moonpunchorg/octeleshield/README.md

# Overclocking telemetry shield for Arduino Yún

Shield for overclocking telemetry, including:

* multi-channel thermocouple measurement
* multi-channel voltrage measurement

## License

Released under [CERN Open Hardware License 1.2](http://www.ohwr.org/projects/cernohl/wiki).
