moonpunchorg/octeleshield/octeleshield.pdf

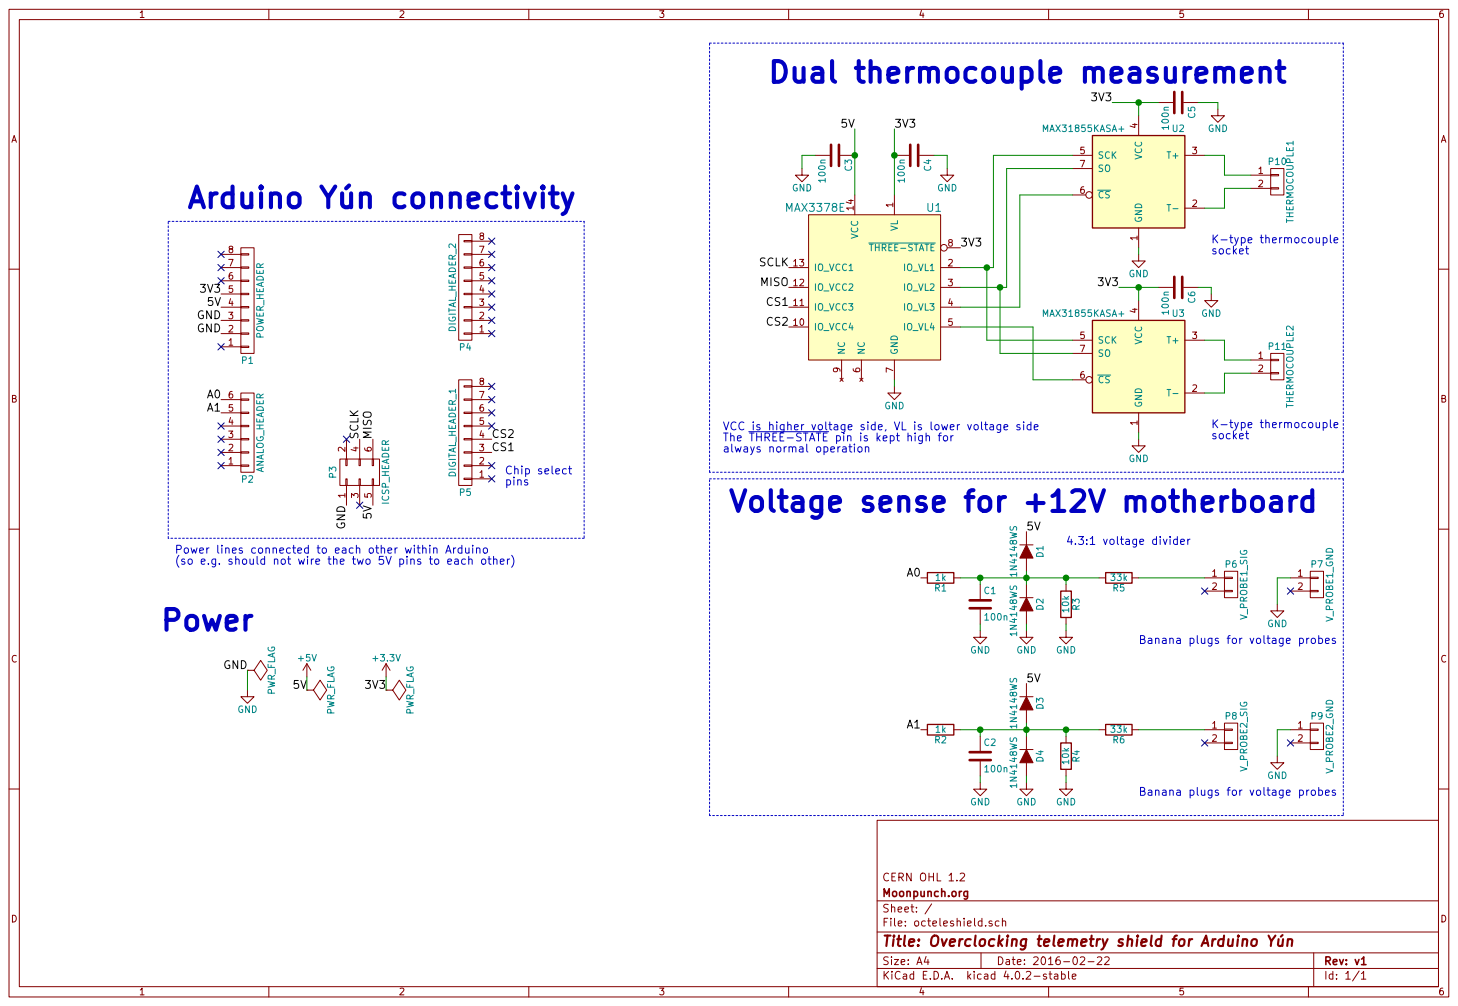
[picture p1: page 1]

3V3 Power lines connected to each other within Arduino

VCC is higher voltage side, VL is lower voltage side
The THREE-STATE pin is kept high for
always normal operation
Voltage sense for +12V motherboard

(so e.g. should not wire the two 5V pins to each other)

Banana plugs for voltage probes

Id: 1/1 Title: Overclocking telemetry shield for Arduino Yún
