moonpunchorg/octeleshield/octeleshield.kicad_pcb

## KiCad design octeleshield.kicad_pcb (2016-03-02)

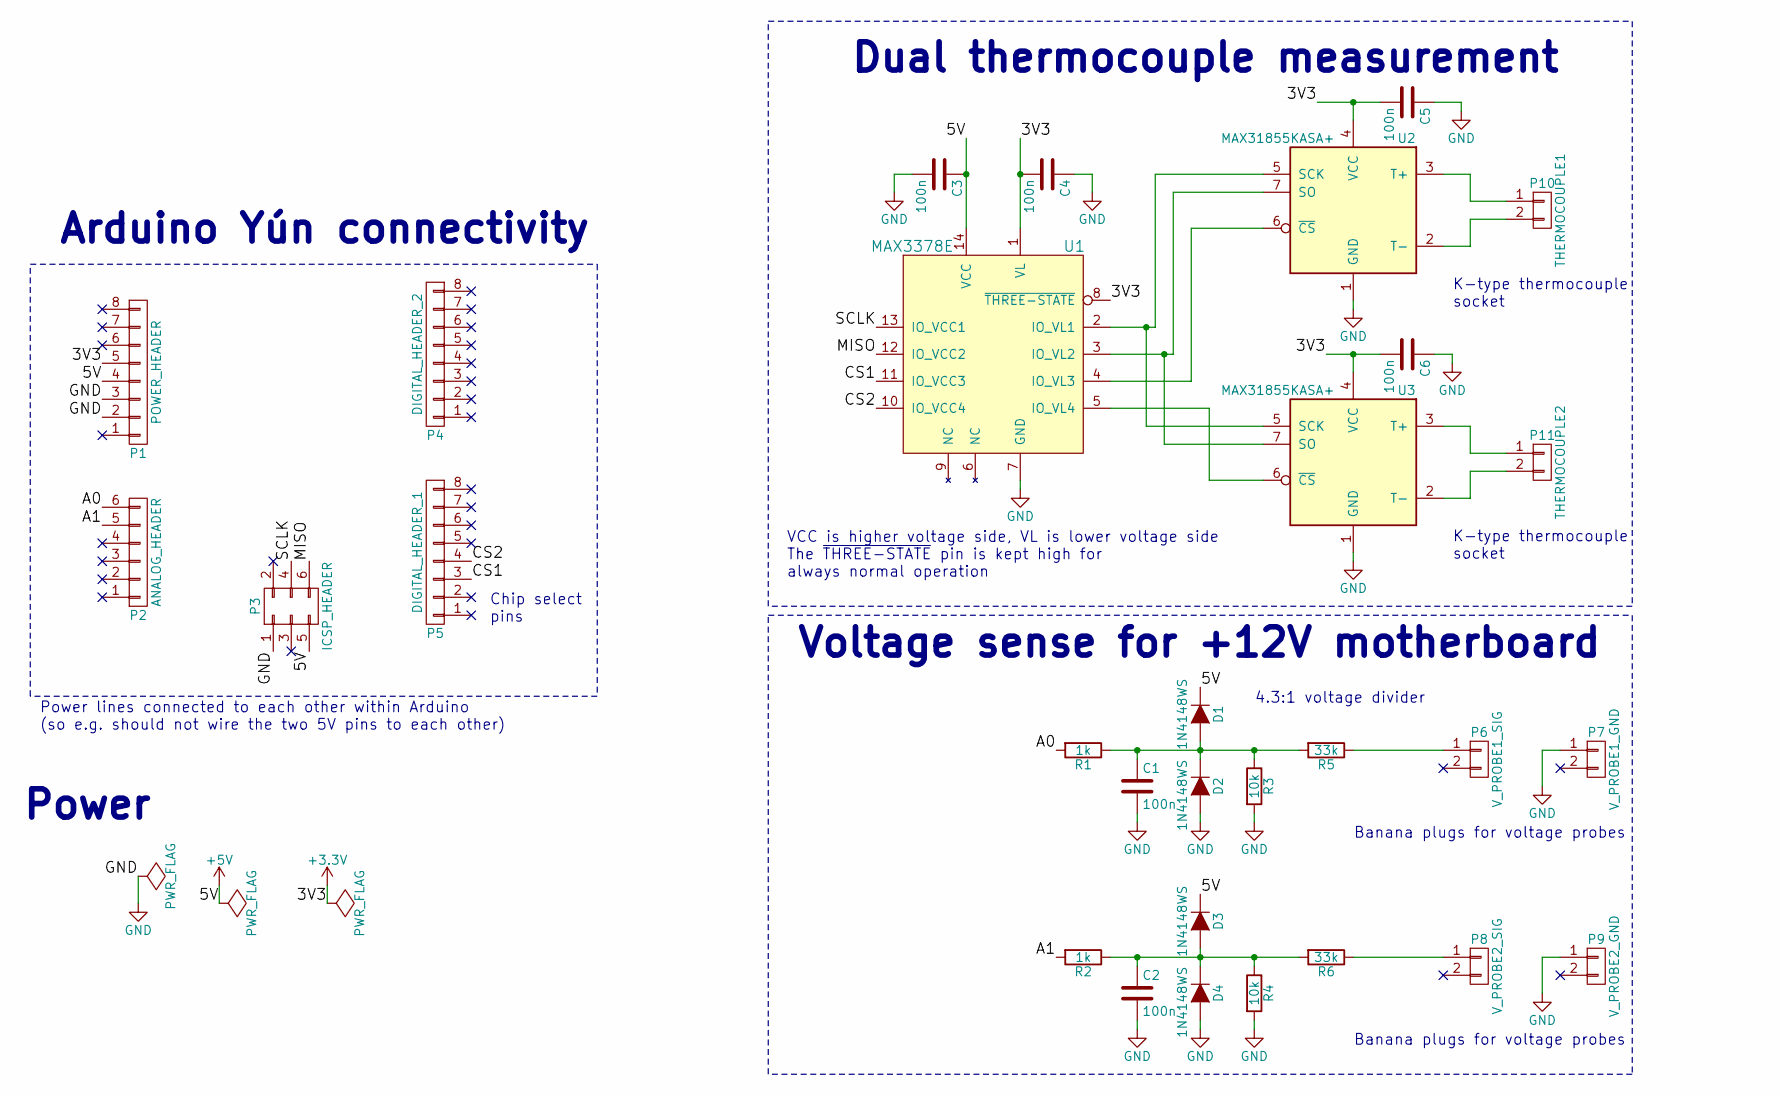
[picture p2: schematic octeleshield.sch, Overclocking telemetry shield for Arduino Yún]

Parts:
C1, C2, C3, C4, C5, C6: 100n; C_0603_HandSoldering
D1, D2, D3, D4: 1N4148WS; SOD-323
P1: POWER_HEADER; Pin_Header_Straight_1x08
P2: ANALOG_HEADER; Pin_Header_Straight_1x06
P3: ICSP_HEADER; Socket_Strip_Straight_2x03
P4: DIGITAL_HEADER_2; Pin_Header_Straight_1x08
P5: DIGITAL_HEADER_1; Pin_Header_Straight_1x08
P6: V_PROBE1_SIG; Test_Probe
P7: V_PROBE1_GND; Test_Probe
P8: V_PROBE2_SIG; Test_Probe
P9: V_PROBE2_GND; Test_Probe
P10: THERMOCOUPLE1; Thermocouple
P11: THERMOCOUPLE2; Thermocouple
R1, R2: 1k; R_0603_HandSoldering
R3, R4: 10k; R_0603_HandSoldering
R5, R6: 33k; R_0603_HandSoldering
U1: MAX3378E; TSSOP-14_4.4x5mm_Pitch0.65mm
U2, U3: MAX31855KASA+; SO-8

Connections:
+3V3: C4.2, C5.2, C6.2, P1.5, U1.1 (VL), U1.8 (~THREE-STATE), U2.4 (VCC), U3.4 (VCC)
+5V: C3.1, D1.1 (K), D3.1 (K), P1.4, P3.5, U1.14 (VCC)
/A0: P2.6, R1.2
/A1: P2.5, R2.2
/CS1: P5.3, U1.11 (IO_VCC3)
/CS2: P5.4, U1.10 (IO_VCC4)
/MISO: P3.6, U1.12 (IO_VCC2)
/SCLK: P3.4, U1.13 (IO_VCC1)
GND: C1.2, C2.2, C3.2, C4.1, C5.1, C6.1, D2.2 (A), D4.2 (A), P1.2, P1.3, P3.1, P7.1, P9.1, R3.2, R4.2, U1.7 (GND), U2.1 (GND), U3.1 (GND)
unnamed: C1.1, D1.2 (A), D2.1 (K), R1.1, R3.1, R5.2
unnamed: C2.1, D3.2 (A), D4.1 (K), R2.1, R4.1, R6.2
unnamed: P6.1, R5.1
unnamed: P8.1, R6.1
unnamed: P10.1, U2.3 (T+)
unnamed: P10.2, U2.2 (T-)
unnamed: P11.1, U3.3 (T+)
unnamed: P11.2, U3.2 (T-)
unnamed: U1.2 (IO_VL1), U2.5 (SCK), U3.5 (SCK)
unnamed: U1.3 (IO_VL2), U2.7 (SO), U3.7 (SO)
unnamed: U1.4 (IO_VL3), U2.6 (~CS~)
unnamed: U1.5 (IO_VL4), U3.6 (~CS~)

Notes on the sheet:
Arduino Yún connectivity
Voltage sense for +12V motherboard
Dual thermocouple measurement
Power
Power lines connected to each other within Arduino (so e.g. should not wire the two 5V pins to each other)
VCC is higher voltage side, VL is lower voltage side The ~THREE-STATE~ pin is kept high for always normal operation
4.3:1 voltage divider
Banana plugs for voltage probes
Banana plugs for voltage probes
K-type thermocouple socket
Chip select pins

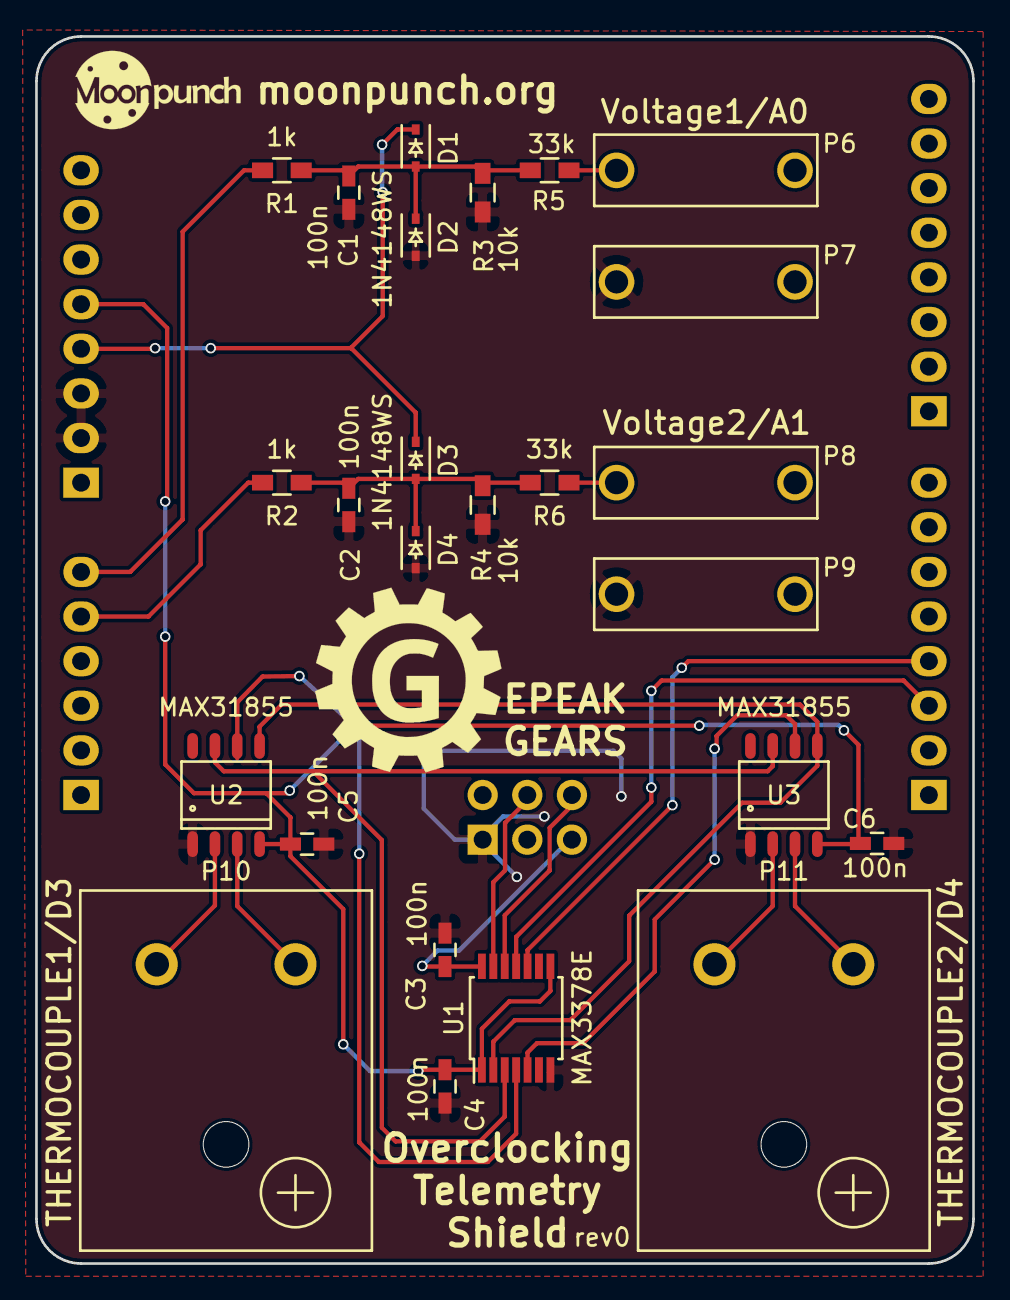
[picture p3: board octeleshield.kicad_pcb from above]

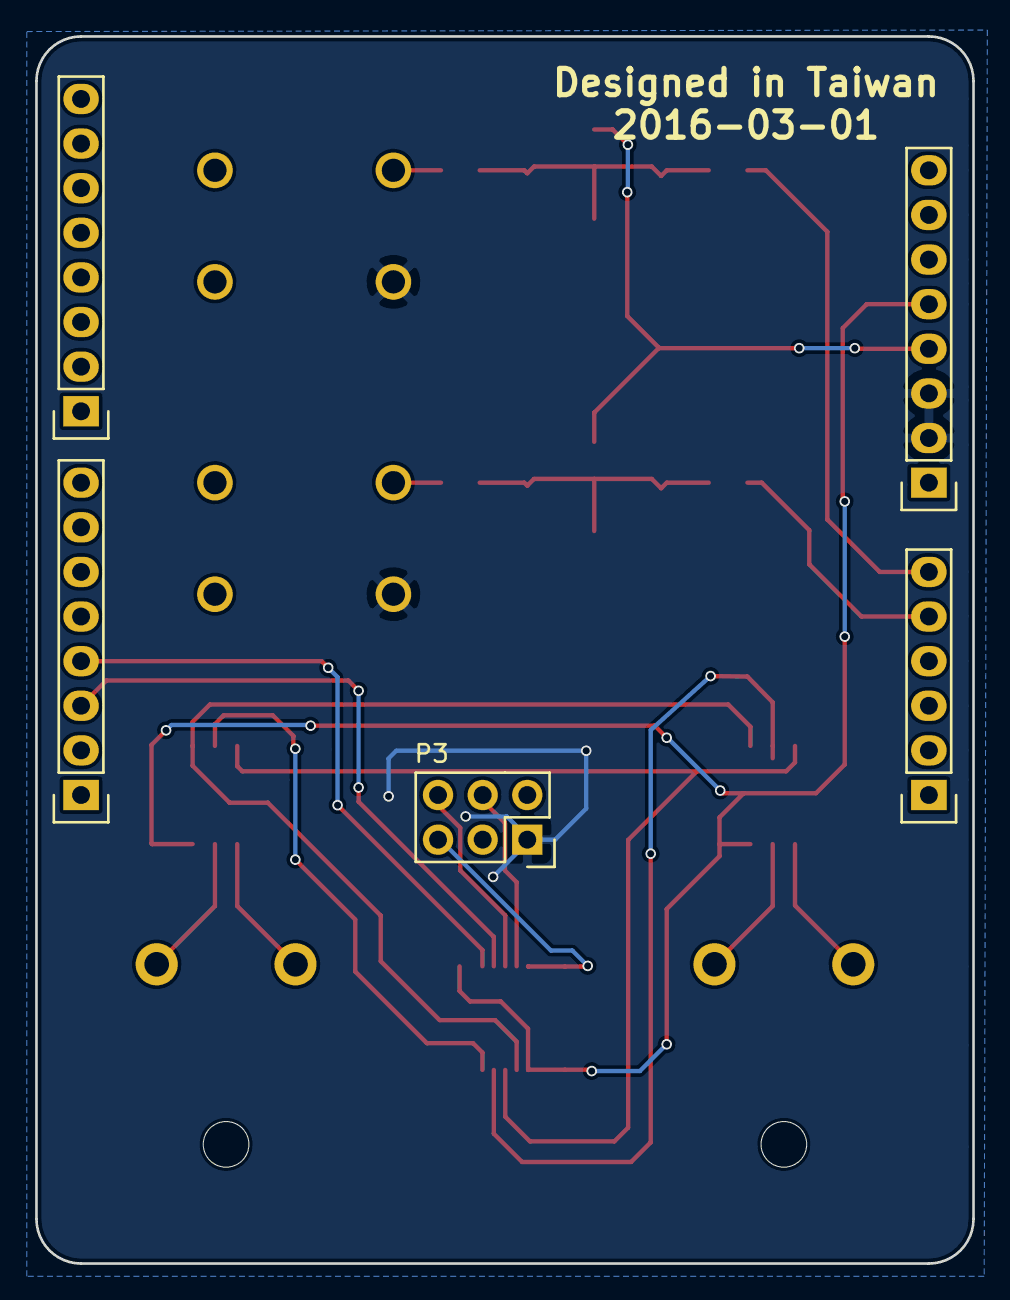
[picture p4: board octeleshield.kicad_pcb from below]

Board: 2 copper layers, 53.3 x 69.9 mm, 30 parts (5 on the bottom side), 21 nets.
