moonpunchorg/octeleshield/(threads)

Thread 1 (2016-05-09):

Improvements from rev0 -> rev1

imrehg, 2016-05-09:
List out things to improve:

- Digital pins for thermocouples: silkscreen is wrong, D2/D3 is the correct (0-based indexing issue)
- Thermocouple sensor: add 10nF ceramic surface-mount capacitor across the T+/T- lines for noise suppression
