moonpunchorg/octeleshield/(commit log)

2016-01-10 work in progress
    [octeleshield.kicad_pcb, octeleshield.sch]
2016-01-11 more work in progress
    [octeleshield.kicad_pcb, octeleshield.sch]
2016-01-17 work in progress, first try of pcb layout
    [octeleshield.kicad_pcb, octeleshield.sch]
2016-01-17 some markup and gerber output directory
    [octeleshield.kicad_pcb, octeleshield.sch]
2016-02-22 work in progress, component updates
    [octeleshield.kicad_pcb, octeleshield.sch]
2016-02-24 more work in progress, getting there
    [octeleshield.kicad_pcb, octeleshield.sch]
2016-03-02 PCB modifications
    [octeleshield.kicad_pcb]
2016-03-02 add gerbers
    [octeleshield-B.Cu.gbl, octeleshield-B.Mask.gbs, octeleshield-B.SilkS.gbo, octeleshield-Edge.Cuts.gm1, octeleshield-F.Cu.gtl, octeleshield-F.Mask.gts, octeleshield-F.SilkS.gto, octeleshield.drl]
2016-03-02 update PCB date
    [octeleshield.kicad_pcb]
2016-03-02 add PDF schematics
2016-03-02 kicad-updated project file
