moonpunchorg/octeleshield/(notices)

Notices in the files:
octeleshield.sch:
CERN OHL 1.2
